TalhaYigit42/scara-chess/hardware/pcb/chess_pcb/chess_pcb.kicad_pcb

## KiCad design Schematic/TX/TX.kicad_sch


Parts:
A1: Arduino_Uno_R4_WiFi_Shield
R1: Throttle; Bourns-PDB18
R2: LCD Brightness; Bourns-PDB18
SW1: Joystick; Joystick_PTH
SW2: Auton Switch; Slide_Switch_SPDT_P3mm_10x5x10mm
U1: LCD_16x4; LCD-16X4

Connections:
GND: A1.GND1 (GND), A1.GND2 (GND), A1.GND3 (GND), R1.1, R2.1, SW1.GND, SW2.1, U1.1 (VSS), U1.5 (RW), U1.15 (LED_A)
unnamed: A1.5V1 (5V), R1.3, R2.3, SW1.VCC, U1.2 (VDD), U1.16 (LED_K)
unnamed: A1.A0, SW1.Vertical
unnamed: A1.A1, SW1.Horizontal
unnamed: A1.A3, R1.2
unnamed: A1.D2, SW2.3
unnamed: A1.D7, U1.4 (RS)
unnamed: A1.D8, U1.6 (E)
unnamed: A1.D9, U1.7 (DB0)
unnamed: A1.D10, U1.8 (DB1)
unnamed: A1.D11, U1.9 (DB2)
unnamed: A1.D12, U1.10 (DB3)
unnamed: R2.2, U1.3 (VO)
