TalhaYigit42/scara-chess/(commit log)

2026-11-09 Remove cache and local calibration files
2026-11-09 Fix typo and clean up error handling in kinematics
2026-11-09 Add servo conversion: angle to ticks, height to angle
2026-11-09 Add joint to servo angle conversion with limit checks
2026-11-09 Reorganize into src/, firmware/ and hardware/
    [chess_pcb.kicad_pcb, chess_pcb.kicad_sch]
2026-11-09 fixing bugs in camera.py, adding stuff to the readme, updating requirements
